jakplugg/pique/readme.md

# Pique; 

4hp version of Mutable Instruments Peaks.

Preliminary
[Google sheets BOM](https://docs.google.com/spreadsheets/d/116DxzQs8hUHfaqHMkBmCd5V-D9WT0mmHaGnENqqx3P8/edit?usp=sharing)
