jakplugg/pique/(list of files, drawings)

Other design files:
PLUM_EXPANDABLE_VERSION/uPeaks_exp02.dch
PLUM_EXPANDABLE_VERSION/uPeaks_exp04.dip
uPeaks.dch
uPeaks.dip
uPeaks_panel.dip
