jakplugg/pique/(threads)

Thread 2 (2020-05-24):

R25 should be lower value on the Plum version

AfterLaterAudio, 2020-05-24:
Due to the lower voltage input the 330R value doesn't allow enough current.  This results in a lower reference voltage (9.8V) but also it fluctuates as knobs are turned making a good calibration impossible.  The poor calibration was big issue for me as envelopes wouldn't completely close.  I have found a value of 200R works much better.

ndoemusic, 2020-05-28:
> Due to the lower voltage input the 330R value doesn't allow enough current. This results in a lower reference voltage (9.8V) but also it fluctuates as knobs are turned making a good calibration impossible. The poor calibration was big issue for me as envelopes wouldn't completely close. I have found a value of 200R works much better.

So is that just for R25 or does that apply to R9.  In the BOM they are the same value so i want to know if i have to change both or leave R9.
Also in my giant box of resistors all i have is 180 R or 220 R would i get better calibration with either of those over the suggested value?

AfterLaterAudio, 2020-05-28:
If you were able to calibrate without values jumping around, then you should be fine.  On mine I would end up with some significant jumping around when I adjusted any knob.  After calibration you should get a maximum of 1mV as a standard output.  I was getting values above 50mV, depending on knob positions.

This adjustment just applies to R25.  I would start with 220R and see if this stabilizes enough.

ndoemusic, 2020-05-28:
> If you were able to calibrate without values jumping around, then you should be fine. On mine I would end up with some significant jumping around when I adjusted any knob. After calibration you should get a maximum of 1mV as a standard output. I was getting values above 50mV, depending on knob positions.
>
> This adjustment just applies to R25. I would start with 220R and see if this stabilizes enough.

I am just about done building my first one,and I have two to build.  So I haven’t tried calibrating it yet.  But I’ll start with what I have I’m sure the 220 will be better then the 330.  Thanks hopfully this will save me some headaches later

sonic2ndtwelve, 2020-10-13:
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

Hello, I'm just wondering of you tried this with the 220ohm resistor and if it calibrated ok. I've just built this with 330ohm and get the same calibration trouble as the OP but I also only have 180 and 220 ohm resistors. Thanks.

Thread 5 (2024-04-01):

Can't read the labels on the PCB and the schematic files are missing?

ntsarb, 2024-04-01:
Hello,

I purchased a jakplugg PCB+panel from Pusherman and the lower part of the PCB has unreadable labels. Also, I could not locate the board and logic circuit schematics in the Github repository. Where can I find which part goes where?

Thank you

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

ntsarb, 2024-04-01:
I will answer my own questions and close this, including the solution. The Gerber files in the Github repository contain the information needed and can be opened from KiCAD.

Closed 2024-04-01.
