jakplugg/pique/(commit log)

2019-05-23 first release
    [PiqueBOM1.0.csv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]
2019-09-22 CNC panel updated
    button holes were moved and the panel was not updated., fixed.
2020-03-14 added plum expandable version
    [uPeaks_exp02.dch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]
